zaljerme/zaid-fly-swarm/hardware/kicad/NETLIST.md

# Zaid Fly carrier — netlist

_Generated by `hardware/tools/generate_kicad.py`._

| Net | Connections |
|---|---|
| `GND` | C5.2, C6.2, C7.2, C8.2, D5.1, D6.1, D7.1, D8.1, D9.1, D10.1, J1.2, J2.2, Q1.2, Q2.2, Q3.2, Q4.2, R1.2, R2.2, R3.2, R4.2, R7.2, R9.2, U1.1, U1.11, U1.18, U1.25, U2.13 |
| `VBAT` | C1.1, C2.1, C3.1, C4.1, D1.1, D2.1, D3.1, D4.1, J1.1, J2.1, M1.1, M2.2, M3.2, M4.1, R8.1 |
| `+3V3` | C5.1, C8.1, R5.1, R6.1, U1.8, U1.13, U2.12 |
| `D10_A` | D10.2, R15.2 |
| `D5_A` | D5.2, R10.2 |
| `D6_A` | D6.2, R11.2 |
| `D7_A` | D7.2, R12.2 |
| `D8_A` | D8.2, R13.2 |
| `D9_A` | D9.2, R14.2 |
| `GATE1` | Q1.1, R1.1, U2.1 |
| `GATE2` | Q2.1, R2.1, U2.2 |
| `GATE3` | Q3.1, R3.1, U2.3 |
| `GATE4` | Q4.1, R4.1, U2.4 |
| `HEAD` | R12.1, R13.1, U2.9 |
| `LED_G` | R11.1, U2.8 |
| `LED_R` | R10.1, U2.7 |
| `MOT1-` | C1.2, D1.2, M1.2, Q1.3 |
| `MOT2-` | C2.2, D2.2, M2.1, Q2.3 |
| `MOT3-` | C3.2, D3.2, M3.1, Q3.3 |
| `MOT4-` | C4.2, D4.2, M4.2, Q4.3 |
| `MPU_AD0` | R7.1, U1.9 |
| `MPU_CPOUT` | C7.1, U1.20 |
| `MPU_REGOUT` | C6.1, U1.10 |
| `SCL` | R6.2, U1.23, U2.6 |
| `SDA` | R5.2, U1.24, U2.5 |
| `TAIL` | R14.1, R15.1, U2.10 |
| `VBAT_SENSE` | R8.2, R9.1, U2.11 |
