zaljerme/zaid-fly-swarm/hardware/bom/zaid-fly-bom.csv

References | Value | Footprint | Part / notes | Qty per drone | Qty for 20 drones
C1 C2 C3 C4 C5 C6 | 0.1uF | C_0603 | 0603 X7R 16V | 6 | 120
C7 C8 | 0.01uF | C_0603 | 0603 X7R 50V | 2 | 40
D1 D2 D3 D4 | 1N4148WS | D_SOD-323 | 1N4148WS flyback (C2128) | 4 | 80
D5 D9 D10 | Red | LED_0603 | 0603 red LED (C2286) | 3 | 60
D6 | Green | LED_0603 | 0603 green LED (C72043) | 1 | 20
D7 D8 | White | LED_0603 | 0603 white LED (C2290) | 2 | 40
J1 | 1S LiPo | Pad_2x_1.7mm_H | JST-PH 2.0 pigtail, 1S 3.7V | 1 | 20
J2 | XIAO BAT | Pad_2x_1.7mm_H | wire link to XIAO BAT+/BAT- pads | 1 | 20
M1 M2 M3 M4 | Motor | Pad_2x_1.7mm | 720 coreless brushed motor (7x20 mm) | 4 | 80
Q1 Q2 Q3 Q4 | SI2300 | SOT-23 | SI2300 N-MOSFET (C10487) | 4 | 80
R1 R2 R3 R4 | 10k | R_0603 | 0603 1% gate pull-down | 4 | 80
R5 R6 R7 R8 R9 | 10k | R_0603 | 0603 1% | 5 | 100
R10 R11 | 200 | R_0603 | 0603 1% | 2 | 40
R12 R13 | 100 | R_0603 | 0603 1% | 2 | 40
R14 R15 | 150 | R_0603 | 0603 1% | 2 | 40
U1 | MPU-6050 | QFN-24_4x4mm_P0.5mm | TDK InvenSense MPU-6050 (LCSC C24112) | 1 | 20
U2 | Seeed XIAO ESP32-S3 | XIAO_ESP32S3_THT | Seeed 113991114 | 1 | 20
