zaljerme/zaid-fly-swarm/3d-models/step/zaid-fly-frame.step

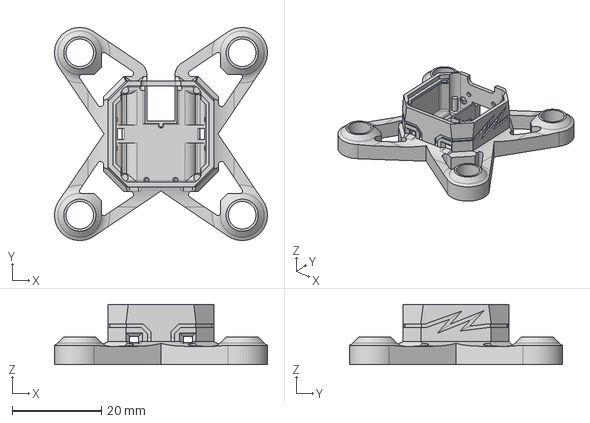
[picture p16: CAD file, 2026-10-18]
3d-models/step/zaid-fly-frame.step
47.8 x 47.8 x 13.5 mm
