zaljerme/zaid-fly-swarm/3d-models/step/zaid-fly-brushless-extended-frame.step

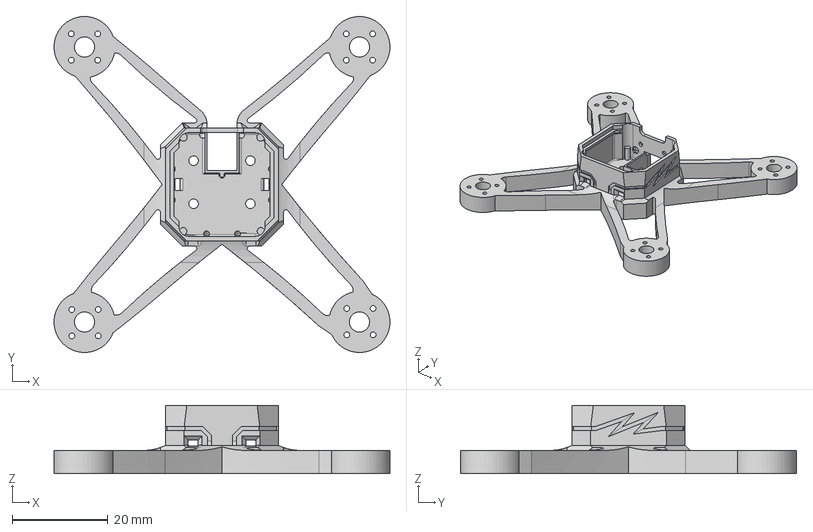
[picture p17: CAD file, 2026-10-18]
3d-models/step/zaid-fly-brushless-extended-frame.step
70.2 x 70.2 x 14.2 mm
