zaljerme/zaid-fly-swarm/3d-models/step/zaid-fly-60mm-brushed-extended-frame.step

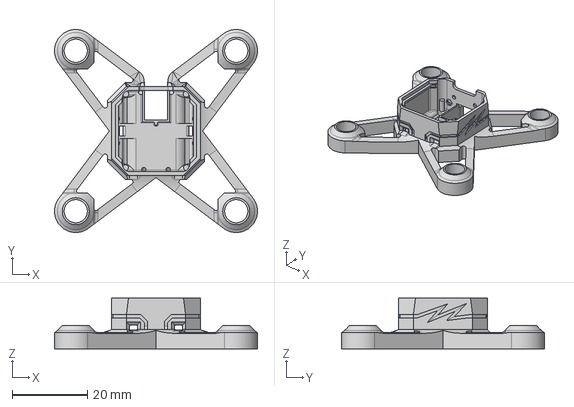
[picture p18: CAD file, 2026-10-18]
3d-models/step/zaid-fly-60mm-brushed-extended-frame.step
54.1 x 54.1 x 13.5 mm
