zaljerme/zaid-fly-swarm/3d-models/step/zaid-fly-cover.step

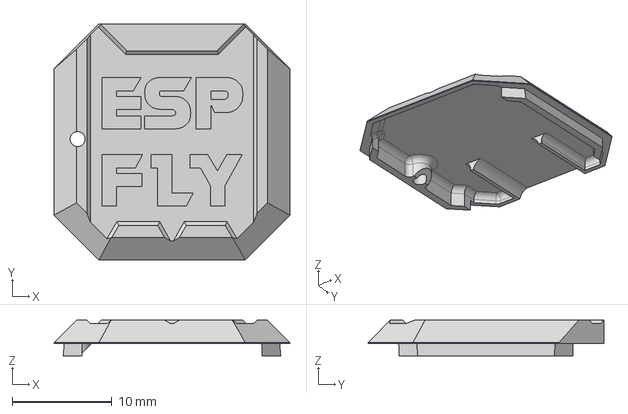
[picture p19: CAD file, 2026-10-18]
3d-models/step/zaid-fly-cover.step
23.7 x 23.7 x 3.60 mm
Cover - Plain
Tri Prop(Mirror)
