zaljerme/zaid-fly-swarm/3d-models/step/zaid-fly-camera-cover.step

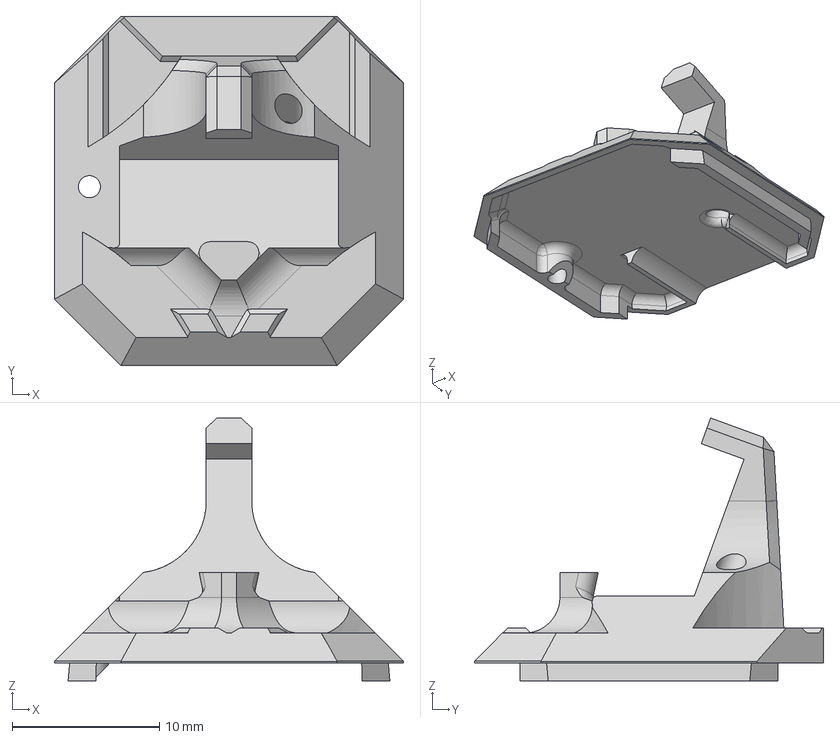
[picture p20: CAD file, 2026-10-18]
3d-models/step/zaid-fly-camera-cover.step
23.7 x 23.7 x 17.9 mm
