zaljerme/zaid-fly-swarm/(list of files, cad)

Other CAD files:
3d-models/stl/zaid-fly-60mm-brushed-extended-frame.stl
3d-models/stl/zaid-fly-brushless-extended-frame.stl
3d-models/stl/zaid-fly-camera-cover.stl
3d-models/stl/zaid-fly-cover.stl
3d-models/stl/zaid-fly-frame.stl
