zaljerme/zaid-fly-swarm/hardware/kicad/zaid-fly.kicad_pcb

## KiCad design hardware/kicad/zaid-fly.kicad_pcb (2026-10-18)

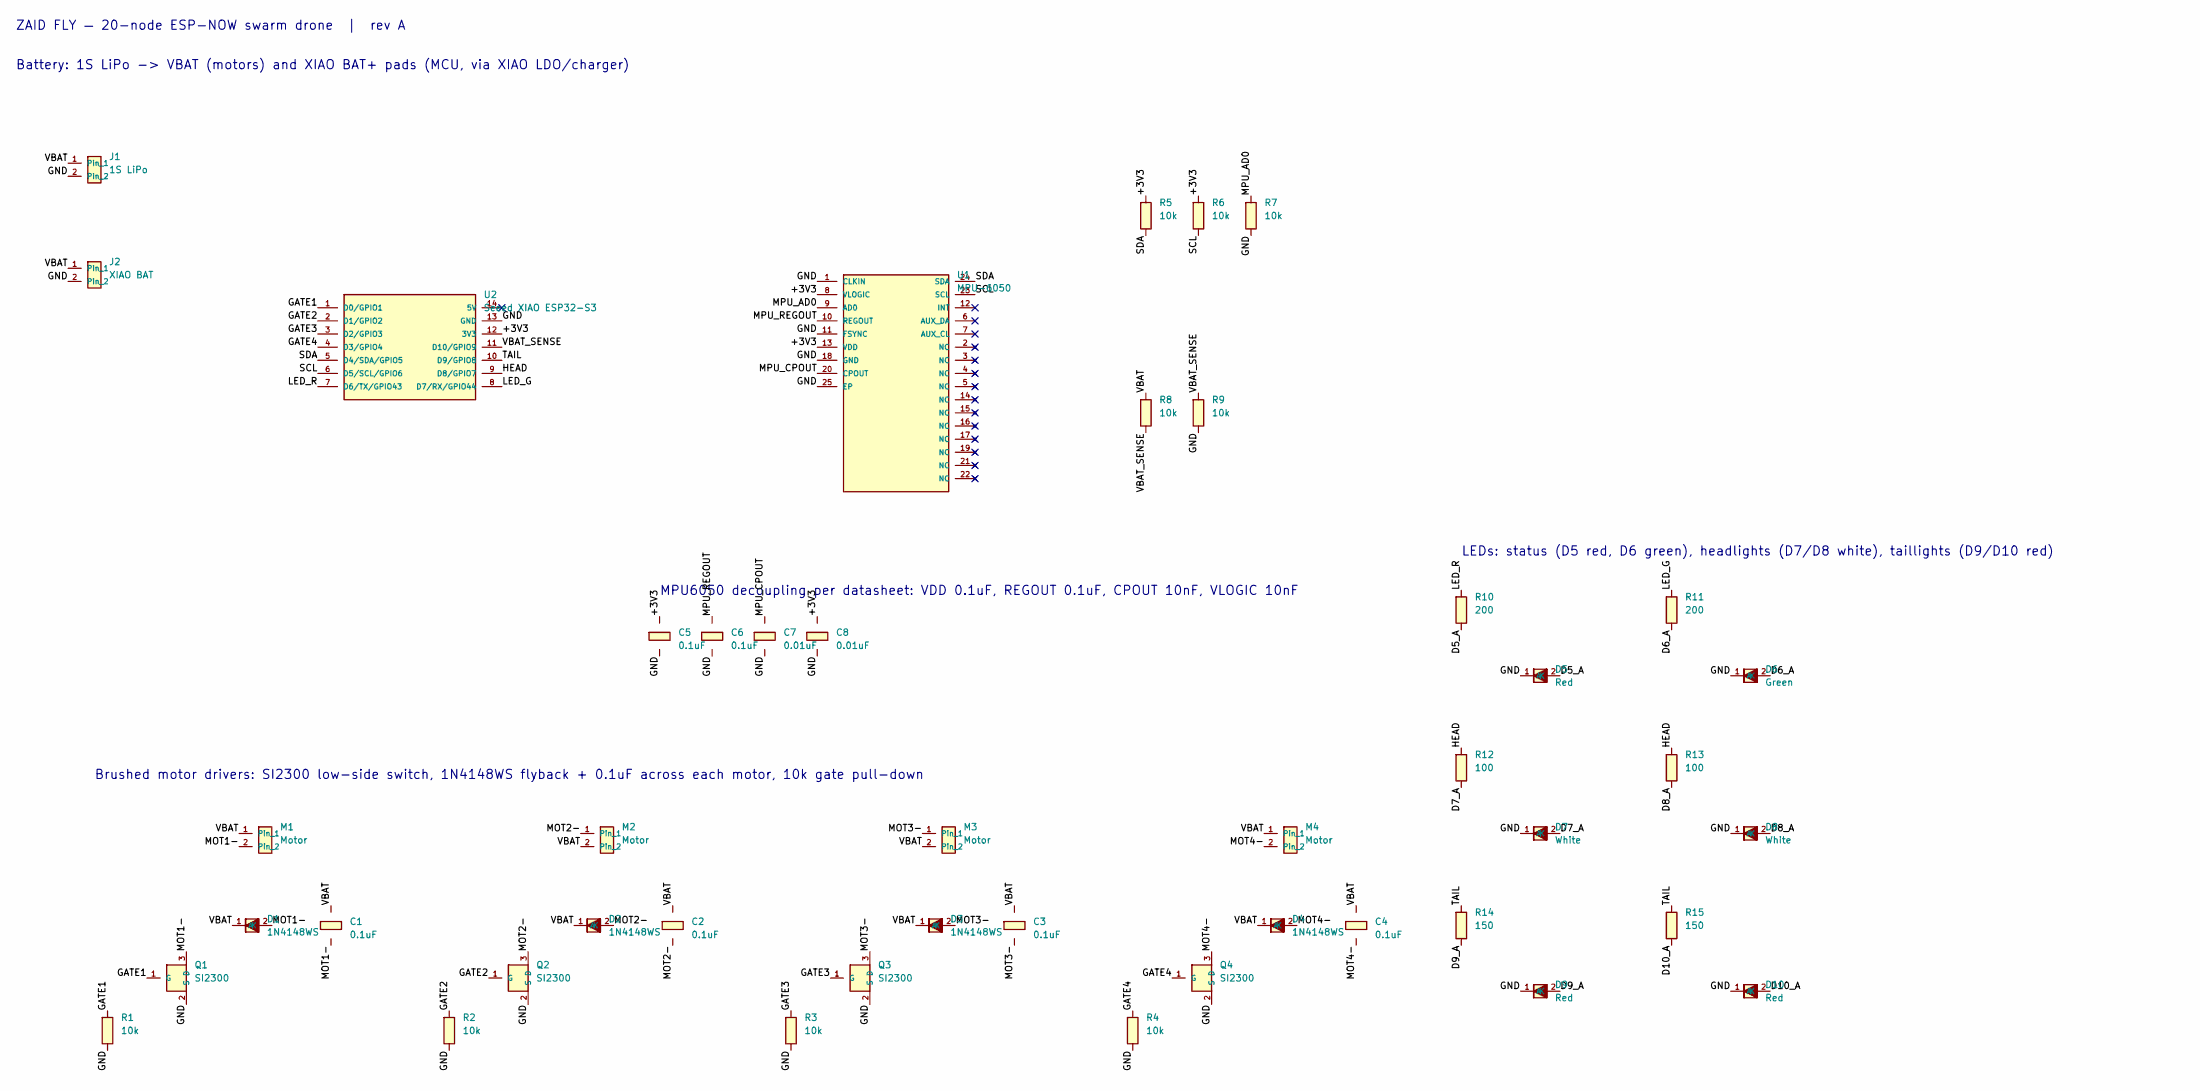
[picture p21: schematic zaid-fly.kicad_sch, Zaid Fly — swarm drone flight controller carrier]

Parts:
C1, C2, C3, C4, C5, C6: 0.1uF; C_0603; MPN 0603 X7R 16V (C14663)
C7, C8: 0.01uF; C_0603; MPN 0603 X7R 50V (C57112)
D1, D2, D3, D4: 1N4148WS; D_SOD-323; MPN 1N4148WS flyback (C2128)
D5, D9, D10: Red; LED_0603; MPN 0603 red LED (C2286)
D6: Green; LED_0603; MPN 0603 green LED (C72043)
D7, D8: White; LED_0603; MPN 0603 white LED (C2290)
J1: 1S LiPo; Pad_2x_1.7mm_H; MPN JST-PH 2.0 pigtail, 1S 3.7V
J2: XIAO BAT; Pad_2x_1.7mm_H; MPN wire link to XIAO BAT+/BAT- pads
M1, M2, M3, M4: Motor; Pad_2x_1.7mm; MPN 720 coreless brushed motor (7x20 mm)
Q1, Q2, Q3, Q4: SI2300; SOT-23; MPN SI2300 N-MOSFET (C10487)
R1, R2, R3, R4: 10k; R_0603; MPN 0603 1% gate pull-down (C25804)
R5, R6, R7, R8, R9: 10k; R_0603; MPN 0603 1% (C25804)
R10, R11: 200; R_0603; MPN 0603 1%
R12, R13: 100; R_0603; MPN 0603 1%
R14, R15: 150; R_0603; MPN 0603 1%
U1: MPU-6050; QFN-24_4x4mm_P0.5mm; MPN TDK InvenSense MPU-6050 (LCSC C24112)
U2: Seeed XIAO ESP32-S3; XIAO_ESP32S3_THT; MPN Seeed 113991114

Connections:
+3V3: C5.1, C8.1, R5.1, R6.1, U1.8 (VLOGIC), U1.13 (VDD), U2.12 (3V3)
D5_A: D5.2 (A), R10.2
D6_A: D6.2 (A), R11.2
D7_A: D7.2 (A), R12.2
D8_A: D8.2 (A), R13.2
D9_A: D9.2 (A), R14.2
D10_A: D10.2 (A), R15.2
GATE1: Q1.1 (G), R1.1, U2.1 (D0/GPIO1)
GATE2: Q2.1 (G), R2.1, U2.2 (D1/GPIO2)
GATE3: Q3.1 (G), R3.1, U2.3 (D2/GPIO3)
GATE4: Q4.1 (G), R4.1, U2.4 (D3/GPIO4)
GND: C5.2, C6.2, C7.2, C8.2, D5.1 (K), D6.1 (K), D7.1 (K), D8.1 (K), D9.1 (K), D10.1 (K), J1.2, J2.2, Q1.2 (S), Q2.2 (S), Q3.2 (S), Q4.2 (S), R1.2, R2.2, R3.2, R4.2, R7.2, R9.2, U1.1 (CLKIN), U1.11 (FSYNC), U1.18 (GND), U1.25 (EP), U2.13 (GND)
HEAD: R12.1, R13.1, U2.9 (D8/GPIO7)
LED_G: R11.1, U2.8 (D7/RX/GPIO44)
LED_R: R10.1, U2.7 (D6/TX/GPIO43)
MOT1-: C1.2, D1.2 (A), M1.2, Q1.3 (D)
MOT2-: C2.2, D2.2 (A), M2.1, Q2.3 (D)
MOT3-: C3.2, D3.2 (A), M3.1, Q3.3 (D)
MOT4-: C4.2, D4.2 (A), M4.2, Q4.3 (D)
MPU_AD0: R7.1, U1.9 (AD0)
MPU_CPOUT: C7.1, U1.20 (CPOUT)
MPU_REGOUT: C6.1, U1.10 (REGOUT)
SCL: R6.2, U1.23 (SCL), U2.6 (D5/SCL/GPIO6)
SDA: R5.2, U1.24 (SDA), U2.5 (D4/SDA/GPIO5)
TAIL: R14.1, R15.1, U2.10 (D9/GPIO8)
VBAT: C1.1, C2.1, C3.1, C4.1, D1.1 (K), D2.1 (K), D3.1 (K), D4.1 (K), J1.1, J2.1, M1.1, M2.2, M3.2, M4.1, R8.1
VBAT_SENSE: R8.2, R9.1, U2.11 (D10/GPIO9)

Notes on the sheet:
ZAID FLY — 20-node ESP-NOW swarm drone | rev A
Battery: 1S LiPo -> VBAT (motors) and XIAO BAT+ pads (MCU, via XIAO LDO/charger)
Brushed motor drivers: SI2300 low-side switch, 1N4148WS flyback + 0.1uF across each motor, 10k gate pull-down
LEDs: status (D5 red, D6 green), headlights (D7/D8 white), taillights (D9/D10 red)
MPU6050 decoupling per datasheet: VDD 0.1uF, REGOUT 0.1uF, CPOUT 10nF, VLOGIC 10nF

Board: 2 copper layers, 45 parts (0 on the bottom side), 27 nets, no tracks yet.
